mayersgm/WaterQualitySystemControl-WQSC-/CAD/WQCS_Encl_lid_v2.step

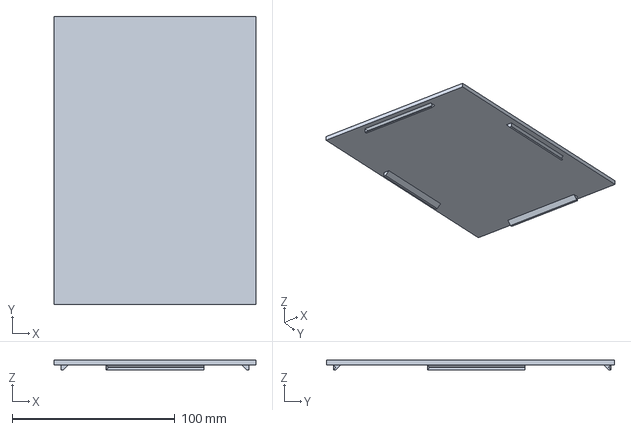
[picture p1: CAD file, 2026-10-28]
CAD/WQCS_Encl_lid_v2.step
124.0 x 177.0 x 6.00 mm
