mayersgm/WaterQualitySystemControl-WQSC-/CAD/WQCS_Enclosure_v2.step

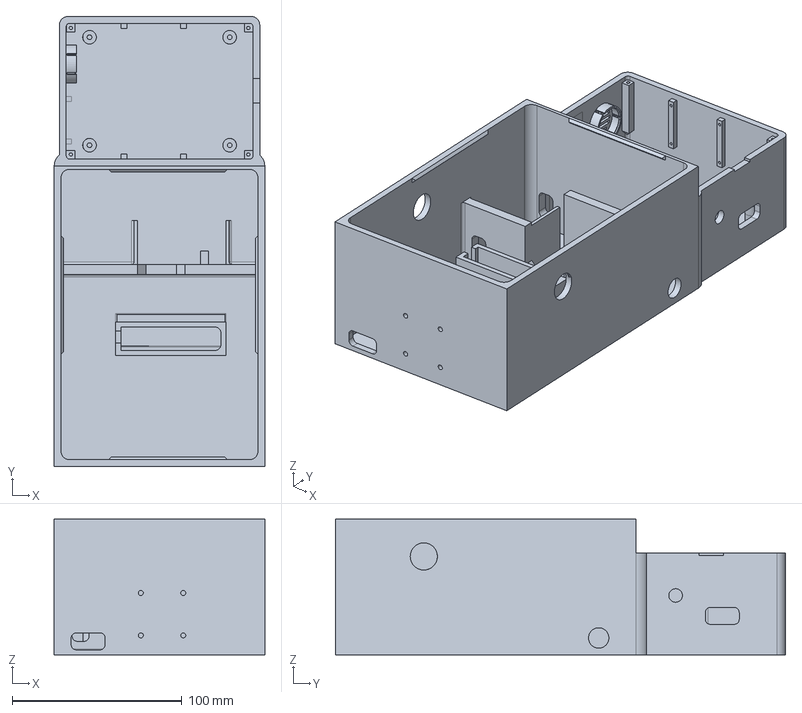
[picture p2: CAD file, 2026-10-28]
CAD/WQCS_Enclosure_v2.step
124.0 x 265.0 x 80.0 mm
