mayersgm/WaterQualitySystemControl-WQSC-/CAD/WQCS_fit_test.step

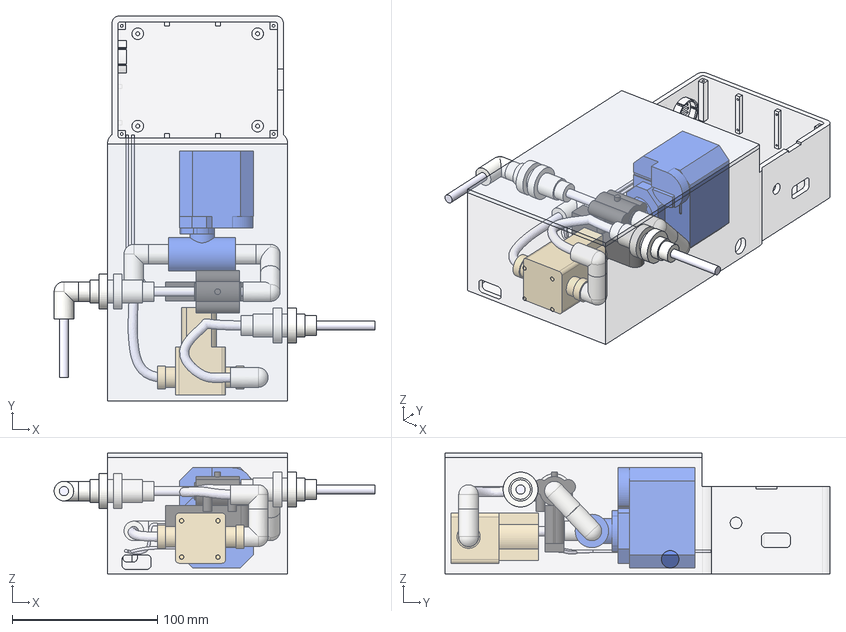
[picture p3: CAD file, 2026-10-28]
CAD/WQCS_fit_test.step
220.8 x 265.0 x 83.0 mm
enclosure_v2
lid_v2
pressure_switch
motorized_valve
solenoid_valve
bulkhead_IN
elbow_IN_outside
elbow_E1
elbow_E2
adapter_valve_R
adapter_valve_L
elbow_E3
elbow_E5
elbow_E6
bulkhead_OUT
switch_pin_1
switch_pin_2
tube_IN_supply
tube_IN_to_switch
tube_through_switch
tube_valve_to_solenoid
tube_solenoid_to_OUT
tube_OUT_boiler
wire_1
wire_1_run
wire_2
wire_2_run
