mayersgm/WaterQualitySystemControl-WQSC-/CAD/Speaker_Test_Coupon.step

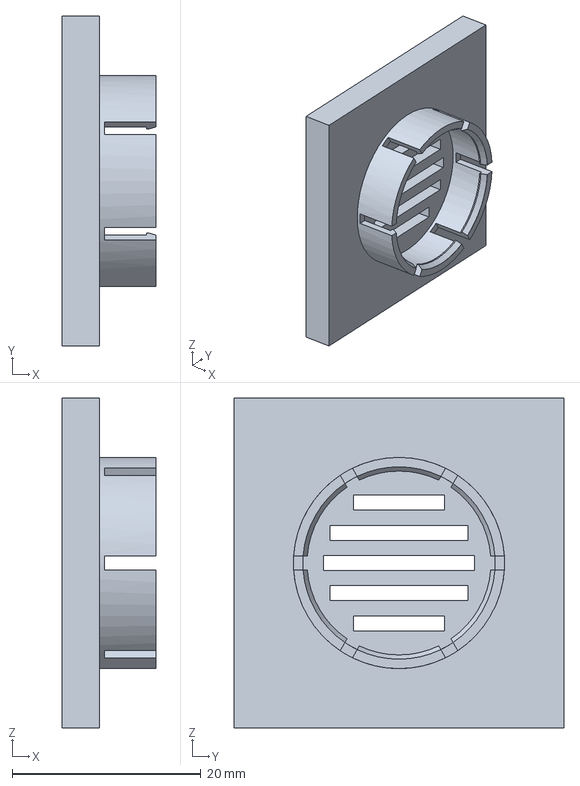
[picture p4: CAD file, 2026-10-28]
CAD/Speaker_Test_Coupon.step
10.0 x 35.0 x 35.0 mm
