mayersgm/WaterQualitySystemControl-WQSC-/CAD/Elec Water Valve.step

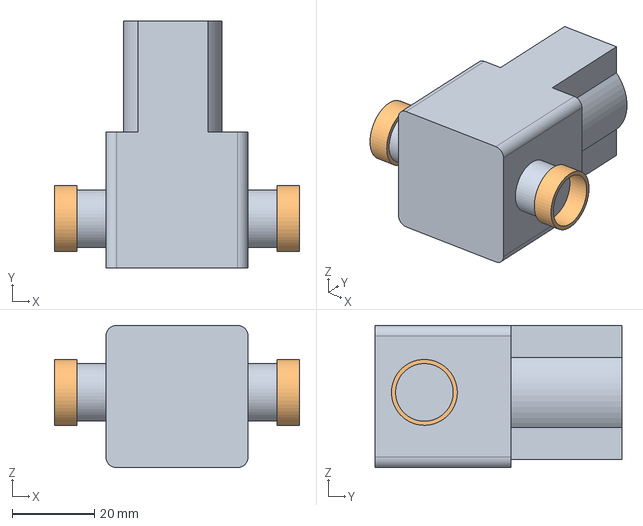
[picture p5: CAD file, 2026-10-25]
CAD/Elec Water Valve.step
59.5 x 60.0 x 34.5 mm
