mayersgm/WaterQualitySystemControl-WQSC-/CAD/Pressure_switch.step

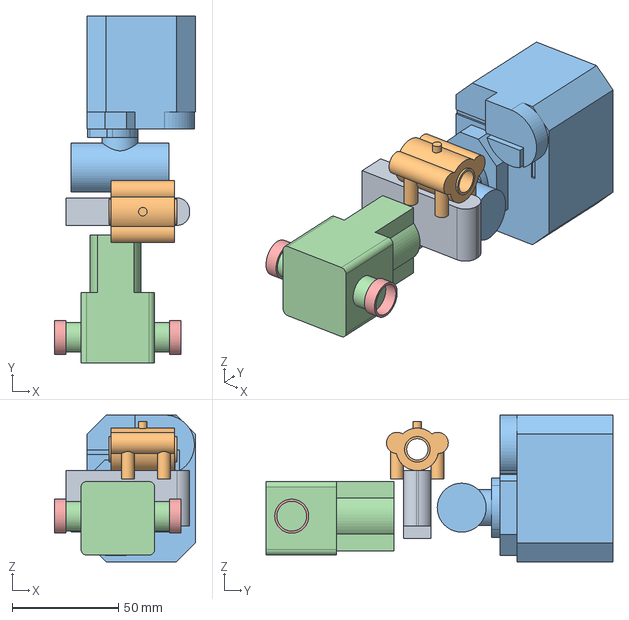
[picture p6: CAD file, 2026-10-25]
CAD/Pressure_switch.step
66.3 x 162.9 x 69.0 mm
VALVE_ENCLOSURE
SV2
