mayersgm/WaterQualitySystemControl-WQSC-/CAD/Display_Cover_v2.step

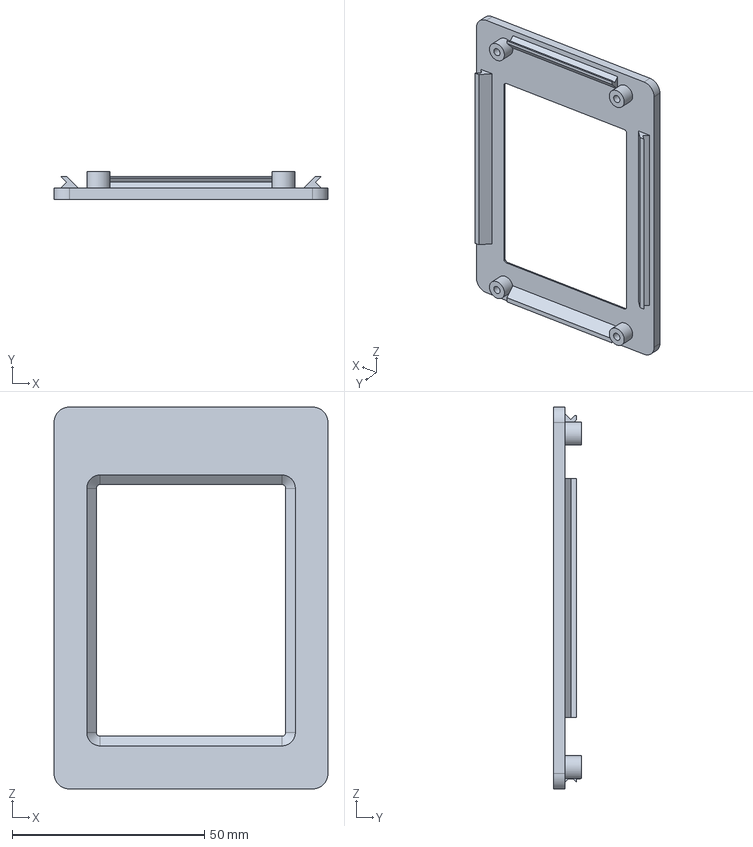
[picture p7: CAD file, 2026-10-25]
CAD/Display_Cover_v2.step
71.2 x 7.30 x 99.3 mm
