mayersgm/WaterQualitySystemControl-WQSC-/CAD/WQCS_Display_Case_v2.step

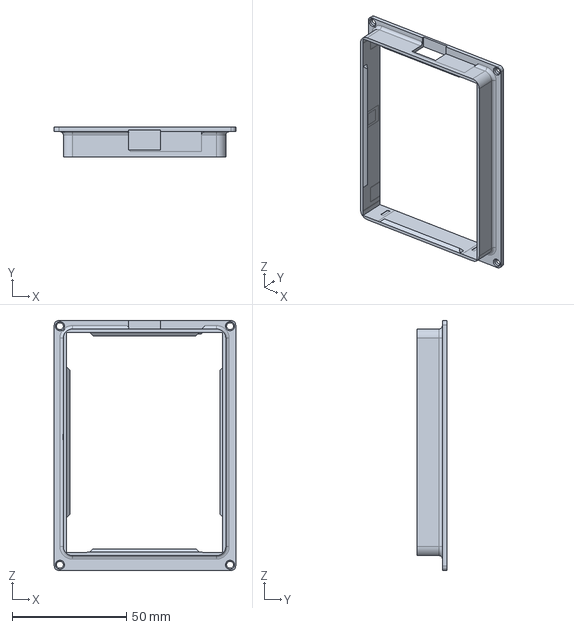
[picture p8: CAD file, 2026-10-25]
CAD/WQCS_Display_Case_v2.step
79.5 x 13.0 x 109.5 mm
