mayersgm/WaterQualitySystemControl-WQSC-/CAD/ESP32-2432S032C.step

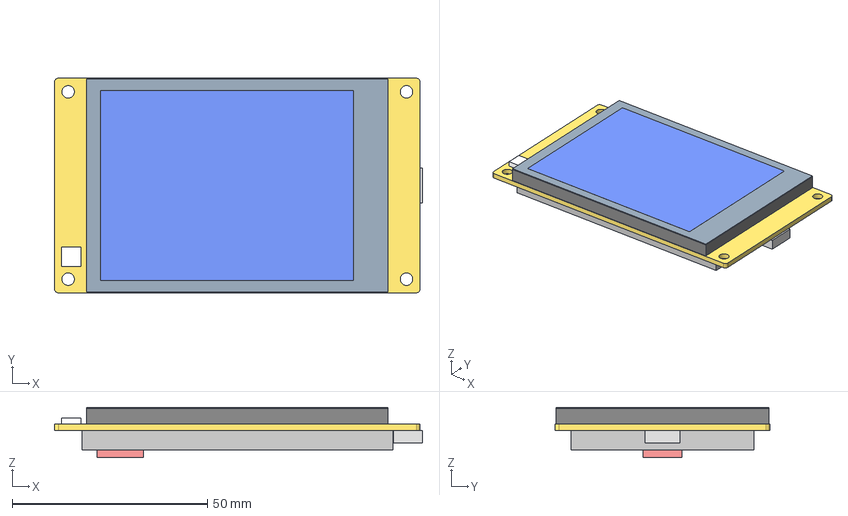
[picture p9: CAD file, 2026-10-24]
CAD/ESP32-2432S032C.step
94.3 x 55.0 x 12.9 mm
pcb
display_module
glass
active_area
back_parts_envelope
speaker_plug_zone
usb_c
rgb_led
