mayersgm/WaterQualitySystemControl-WQSC-/CAD/wqcs_pcb.step

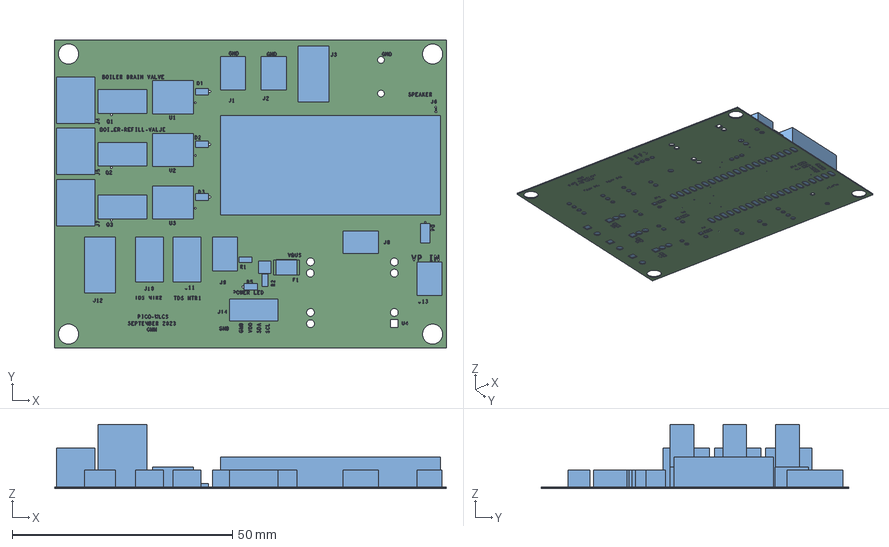
[picture p10: CAD file, 2026-10-22]
CAD/wqcs_pcb.step
88.9 x 69.8 x 14.6 mm
