mayersgm/WaterQualitySystemControl-WQSC-/CAD/WQCS_Display_Case_v1.step

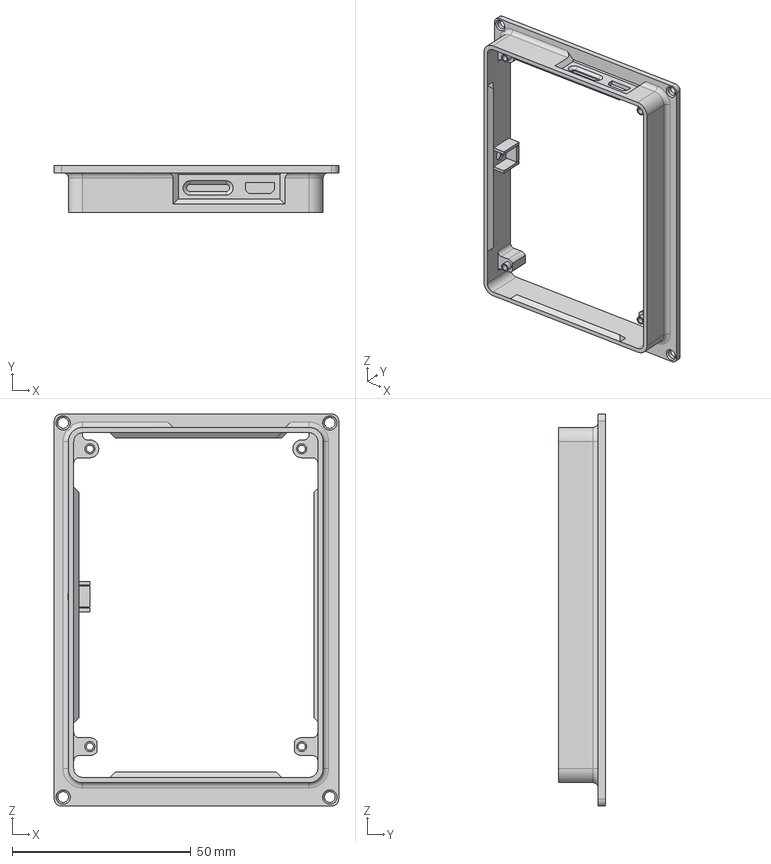
[picture p11: CAD file, 2026-10-23, an earlier design]
CAD/WQCS_Display_Case_v1.step
79.5 x 13.0 x 109.5 mm
