mayersgm/WaterQualitySystemControl-WQSC-/CAD/Display_Cover.step

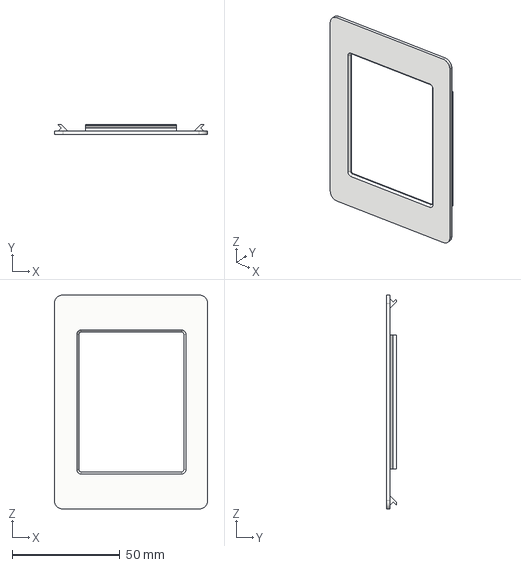
[picture p12: CAD file, 2026-10-23, an earlier design]
CAD/Display_Cover.step
71.2 x 4.50 x 99.3 mm
Parts
Case Plate
