mayersgm/WaterQualitySystemControl-WQSC-/CAD/WQCS_Encl_lid_v1.step

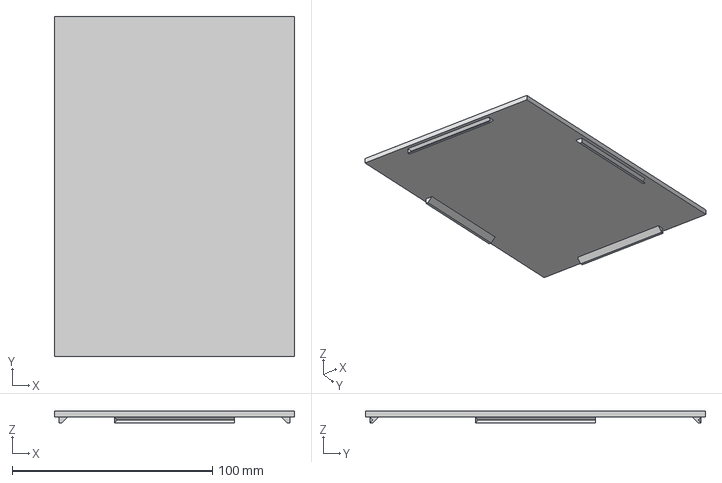
[picture p13: CAD file, 2026-10-20, an earlier design]
CAD/WQCS_Encl_lid_v1.step
120.0 x 170.0 x 6.00 mm
