mayersgm/WaterQualitySystemControl-WQSC-/CAD/WQCS_Enclosure_v1.step

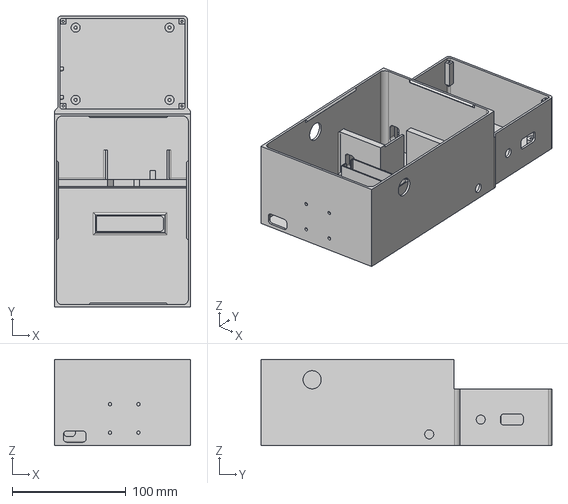
[picture p14: CAD file, 2026-10-20, an earlier design]
CAD/WQCS_Enclosure_v1.step
120.0 x 256.0 x 76.0 mm
