mayersgm/WaterQualitySystemControl-WQSC-/(list of files, cad)

Other CAD files:
CAD/MotorizeValve.step
CAD/Display_Cover_v2.stl
CAD/Speaker_Test_Coupon.stl
CAD/WQCS_Display_Case_v2.stl
CAD/WQCS_Encl_lid_v2.stl
CAD/WQCS_Enclosure_v2.stl
