mayersgm/WaterQualitySystemControl-WQSC-/LoadCells/Wiring1_ 2026-05-20 at 11.27.05 PM.png

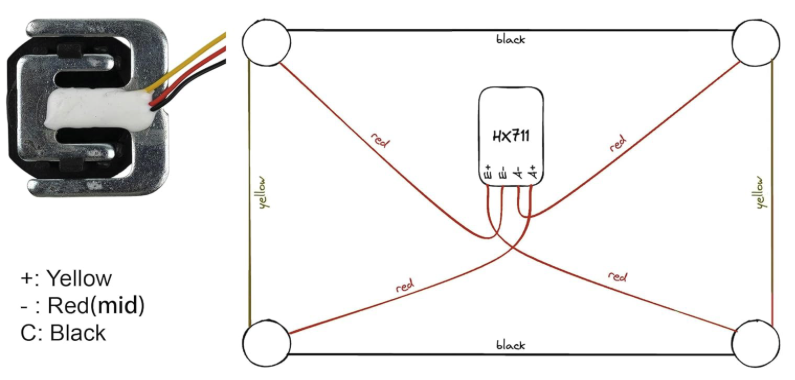
LoadCells/Wiring1_ 2026-05-20 at 11.27.05 PM.png
