mayersgm/WaterQualitySystemControl-WQSC-/LoadCells/Wiring2_2026-05-22 at 11.45.17 AM.png

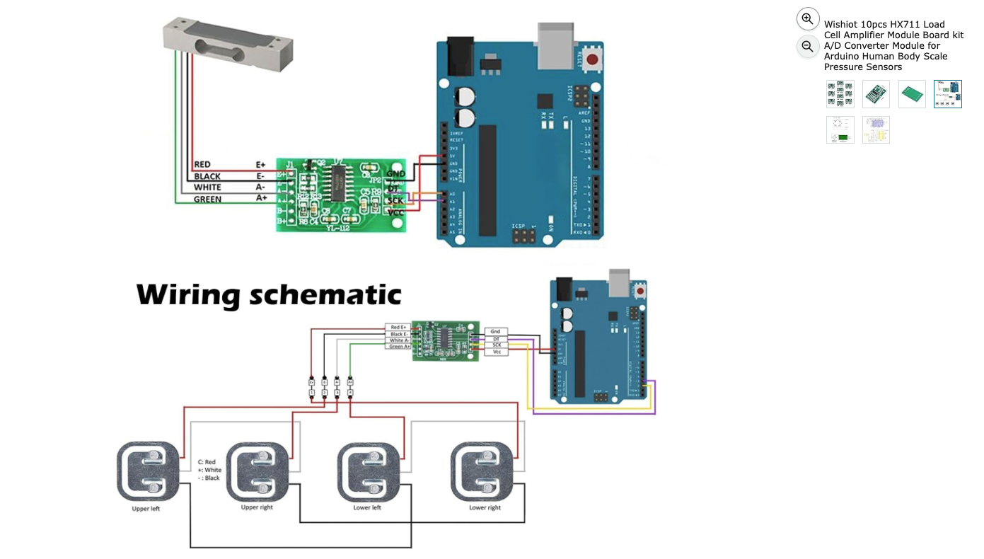
LoadCells/Wiring2_2026-05-22 at 11.45.17 AM.png
