mayersgm/WaterQualitySystemControl-WQSC-/ESP-S32CI/dashboard.py

"""Main operator screen: state, vessel levels, live indicators, commands."""
import lvgl as lv
import widgets as w
from icons import Flame, Drops, Valve, FlowArrow

BAR_Y, BAR_H = 18, 70
VESSEL_Y, VESSEL_H = 32, 116
TILE_Y, TILE_H = 151, 46

TDS_FAULT_PPM = 50                 # mirrors Pico/main.py TDS_FAULT_PPM
TDS_WARN_PPM = TDS_FAULT_PPM * 4 // 5

FAULT_NAMES = {"tds1": "TDS-1", "overflow": "BOILER OVFL",
               "refill_timeout": "REFILL T/O", "valve_stuck": "VALVE STUCK",
               "collector_overflow": "COLL OVFL", "reservoir_overflow": "RES OVFL",
               "transfer_leak": "XFER LEAK", "controller": "CTRL STALL",
               "sensor": "SENSOR"}

STATE_STYLE = {
    "RUN": (w.GREEN, "RUN - distilling"),
    "IDLE": (w.BLUE, "IDLE - filling boiler"),
    "STANDBY": (w.AMBER, "STANDBY - no room"),
    "STOPPED": (w.GREY, "STOPPED"),
    "EMPTY": (w.TEAL, "EMPTY - drain mode"),
    "FAULT": (w.RED, "FAULT"),
}

# setpoints drawn as markers on each vessel (FULL is the top of the bar)
MARKERS = {
    "boiler": ("boiler_topoff", "boiler_full"),
    "collector": ("collector_empty", "collector_full"),
    "reservoir": ("reservoir_full",),
}


class _Vessel:
    """Level bar scaled to the operator's settings: 0% = empty, 100% = the
    vessel's FULL setpoint (falls back to physical capacity until the Pico's
    limits arrive). The % label can exceed 100 and the bar turns amber at/over
    FULL, so overfill stays visible."""

    def __init__(self, parent, name, title, x):
        self.name = name
        self.full = None
        self.g = None
        self.panel = w.box(parent, x, VESSEL_Y, 104, VESSEL_H)
        w.label(self.panel, title, color=w.MUTED).set_pos(6, 3)
        self.bar = lv.bar(self.panel)
        self.bar.set_pos(8, BAR_Y)
        self.bar.set_size(40, BAR_H)
        self.bar.set_range(0, 100)
        # Indicator radius must be >= the bar's: if it's smaller, LVGL clips
        # the indicator through an ARGB8888 layer (40x70x4 = 11 KB) on every
        # redraw, which fragmented the heap until rendering hit MemoryError
        # (lv_bar.c draw_indic "radius_issue", 2026-10-03).
        self.bar.set_style_radius(4, 0)
        self.bar.set_style_radius(4, lv.PART.INDICATOR)
        self.bar.set_style_bg_color(lv.color_hex(0x0B1015), 0)
        self.bar.set_style_bg_opa(lv.OPA.COVER, 0)
        self.bar.set_style_bg_color(w.WATER, lv.PART.INDICATOR)
        self.markers = {}
        for key in MARKERS[name]:
            m = w.box(self.panel, 4, BAR_Y, 48, 2, w.AMBER, radius=0)
            m.add_flag(lv.obj.FLAG.HIDDEN)
            self.markers[key] = m
        self.grams = w.label(self.panel, "--", w.FONT_M)
        self.grams.set_pos(6, BAR_Y + BAR_H + 4)
        self.pct = w.label(self.panel, "", color=w.MUTED)
        self.pct.set_pos(56, 3)
        self.room = None
        if name == "reservoir":
            # "no room" line: above it, a full collector no longer fits
            self.room = w.box(self.panel, 4, BAR_Y, 48, 2, w.TEAL, radius=0)
            self.room.add_flag(lv.obj.FLAG.HIDDEN)

    def _pct(self, g):
        scale = self.full or w.CAPACITY[self.name]
        return int(100 * g / scale) if scale > 0 else 0

    def _y(self, p):
        p = max(0, min(100, p))
        return BAR_Y + BAR_H - 1 - (BAR_H * p) // 100

    def set_weight(self, g):
        self.g = g
        if g is None:
            return
        p = self._pct(g)
        bar_p = max(0, min(100, p))
        if w.changed(self.bar, "value", bar_p):
            self.bar.set_value(bar_p, True)  # LVGL 9: lv_anim_enable_t is a bool, no lv.ANIM enum
        over = self.full is not None and g >= self.full
        if w.changed(self.bar, "over", over):
            self.bar.set_style_bg_color(w.AMBER if over else w.WATER, lv.PART.INDICATOR)
        # 10 g resolution: sub-10 g scale jitter would otherwise redraw every second
        w.set_text(self.grams, w.fmt_g(round(g, -1)))
        w.set_text(self.pct, "%d%%" % p)

    def set_limits(self, limits):
        self.full = limits.get(self.name + "_full") or None
        for key, m in self.markers.items():
            if key in limits:
                m.set_y(self._y(self._pct(limits[key])))
                m.remove_flag(lv.obj.FLAG.HIDDEN)
        if self.g is not None:
            self.set_weight(self.g)   # rescale the bar to the new FULL

    def set_room_line(self, room_g):
        """Reservoir only: level above which a full collector won't fit."""
        if self.room is None or self.full is None:
            return
        y = self._y(self._pct(room_g))
        if w.changed(self.room, "y", y):
            self.room.set_y(y)
        w.set_hidden(self.room, False)


class _Tile:
    """Sensor readout: small title, large value, colored by status."""

    def __init__(self, parent, title, x):
        self.panel = w.box(parent, x, TILE_Y, 104, TILE_H)
        w.label(self.panel, title, color=w.MUTED).set_pos(6, 3)
        self.value = w.label(self.panel, "--", w.FONT_L, w.MUTED)
        self.value.set_pos(6, 18)

    def set(self, text, color):
        w.set_text(self.value, text)
        w.set_text_color(self.value, color)


def _tds_color(ppm, faulted):
    if faulted or ppm >= TDS_FAULT_PPM:
        return w.RED
    return w.AMBER if ppm >= TDS_WARN_PPM else w.GREEN


class Dashboard:
    def __init__(self, on_command, on_cal, on_levels, on_ack):
        self.on_command = on_command
        self.scr = w.screen()
        self.cmd = None
        self.frame = 0

        self.banner = w.box(self.scr, 0, 0, 320, 30, w.GREY, radius=0)
        self.state_lbl = w.label(self.banner, "WAITING FOR PICO...", w.FONT_M)
        self.state_lbl.align(lv.ALIGN.LEFT_MID, 8, 0)
        w.button(self.banner, "CAL", on_cal, 222, 2, 44, 26, w.PANEL, w.FONT_S)
        w.button(self.banner, lv.SYMBOL.SETTINGS + " LVL", on_levels, 270, 2, 48, 26,
                 w.PANEL, w.FONT_S)
        # shown only while a fault is latched; the fault names go in state_lbl
        self.btn_ack = w.button(self.banner, "ACK", on_ack,
                                166, 2, 52, 26, lv.color_hex(0x7F0000), w.FONT_M, tone=w.TONE_ACK)
        self.btn_ack.add_flag(lv.obj.FLAG.HIDDEN)

        self.vessels = {
            "boiler": _Vessel(self.scr, "boiler", "BOILER", 2),
            "collector": _Vessel(self.scr, "collector", "COLLECTOR", 108),
            "reservoir": _Vessel(self.scr, "reservoir", "RESERVOIR", 214),
        }
        bp = self.vessels["boiler"].panel
        self.main_valve = Valve(bp, 54, 18, "MAIN")
        self.drops = Drops(bp, 58, 32, height=20)
        self.flame = Flame(bp, 62, 56)
        self.psw = Valve(bp, 58, 94, "PSW")
        cp = self.vessels["collector"].panel
        w.label(cp, "XFER", color=w.MUTED).set_pos(58, 36)
        self.flow = FlowArrow(cp, 56, 52)
        self.animated = (self.flame, self.drops, self.flow)

        self.t_temp = _Tile(self.scr, "BOILER TEMP", 2)
        self.t_tds1 = _Tile(self.scr, "TDS-1 DISTILL", 108)
        self.t_tds2 = _Tile(self.scr, "TDS-2 OUTLET", 214)

        cmd = w.TONE_CMD
        self.btn_start = w.button(self.scr, "START", self._start_stop, 2, 201, 76, 37, w.GREEN,
                                  tone=cmd)
        self.btn_ster = w.button(self.scr, "STERILIZE", self._sterilize, 82, 201, 76, 37,
                                 w.PURPLE, w.FONT_S, tone=cmd)
        self.btn_empty = w.button(self.scr, "EMPTY", self._empty, 162, 201, 76, 37, w.TEAL,
                                  tone=cmd)
        w.button(self.scr, "RESET", lambda: on_command("RESET"), 242, 201, 76, 37, w.GREY,
                 tone=cmd)

        lv.timer_create(self._animate, 150, None)

    # -- commands: labels follow the Pico's reported cmd, not local state --
    def _start_stop(self):
        self.on_command("STOP" if self.cmd == "START" else "START")

    def _sterilize(self):
        self.on_command("STOP" if self.cmd == "STERILIZE" else "STERILIZE")

    def _empty(self):
        self.on_command("STOP" if self.cmd == "EMPTY" else "EMPTY")

    def _animate(self, timer):
        self.frame += 1
        for icon in self.animated:
            icon.step(self.frame)

    # -- data in --
    def update(self, s):
        self.cmd = s.get("cmd")
        state = s.get("state", "")
        color, text = STATE_STYLE.get(state, (w.GREY, state))
        if state == "RUN" and self.cmd == "STERILIZE":
            text = "RUN - sterilizing"
        elif state == "STANDBY":
            # collector FULL: draining into the reservoir, or waiting for room
            text = ("STANDBY - transferring" if s.get("valves", {}).get("transfer")
                    else "STANDBY - no room")
        faults = [k for k, on in s.get("fault", {}).items() if on]
        if faults:
            color = w.RED
            text = "FAULT " + "+".join(FAULT_NAMES.get(k, k) for k in faults)
        w.set_hidden(self.btn_ack, not faults)
        self._set_banner(color, text, small=bool(faults))

        for name, v in self.vessels.items():
            v.set_weight(s.get(name + "_g"))
        res, coll_g = self.vessels["reservoir"], s.get("collector_g")
        if res.full is not None and coll_g is not None:
            res.set_room_line(res.full - max(0, coll_g))

        valves = s.get("valves", {})
        self.main_valve.set_active(bool(valves.get("main")))
        self.drops.set_active(bool(valves.get("refill")))
        self.flow.set_active(bool(valves.get("transfer")))
        self.flame.set_active(bool(s.get("heater")))
        self.psw.set_active(bool(s.get("pressure_sw")))

        temp = s.get("temp_f")
        if temp is None:
            self.t_temp.set("-- F", w.MUTED)  # sensor missing / out of range
        else:
            self.t_temp.set("%.0f F" % temp, w.AMBER if self.flame.active else w.TEXT)
        tds1 = s.get("tds1_ppm") or 0
        tds2 = s.get("tds2_ppm") or 0
        self.t_tds1.set("%d ppm" % tds1, _tds_color(tds1, s.get("fault", {}).get("tds1")))
        self.t_tds2.set("%d ppm" % tds2, _tds_color(tds2, s.get("alert", {}).get("tds2")))

        w.set_button_text(self.btn_start, "STOP" if self.cmd == "START" else "START")
        w.set_bg(self.btn_start, w.RED if self.cmd == "START" else w.GREEN)
        w.set_button_text(self.btn_ster, "CANCEL" if self.cmd == "STERILIZE" else "STERILIZE")
        w.set_button_text(self.btn_empty, "CANCEL" if self.cmd == "EMPTY" else "EMPTY")

    def _set_banner(self, color, text, small=False):
        w.set_bg(self.banner, color)
        w.set_text_color(self.state_lbl, w.DARK_TEXT if color is w.AMBER else w.TEXT)
        if w.changed(self.state_lbl, "small", small):
            self.state_lbl.set_style_text_font(w.FONT_S if small else w.FONT_M, 0)
        if w.changed(self.state_lbl, "text", text):
            self.state_lbl.set_text(text)
            self.state_lbl.align(lv.ALIGN.LEFT_MID, 8, 0)

    def update_limits(self, limits):
        for v in self.vessels.values():
            v.set_limits(limits)

    def show_link_lost(self, errors):
        self._set_banner(w.PURPLE, "NO LINK TO PICO" + (" (err %d)" % errors if errors else ""))
