mayersgm/WaterQualitySystemControl-WQSC-/tests/test_control.py

"""Runs the Pico's real _control_step against scripted weights (bench limits:
collector_full 500, collector_empty 100, reservoir_full 1000; overflow ceilings
boiler 900 / collector 900 / reservoir 1200)."""
import os
import tempfile
import unittest

import fake_pico


class ControlTest(unittest.TestCase):
    def setUp(self):
        self._cwd = os.getcwd()
        self.dir = tempfile.TemporaryDirectory()
        self.main, self.w = fake_pico.make_controller(self.dir.name)
        # the bench pressure-switch stand-in follows the refill command; keep it
        # "healthy" so the unrelated stuck-solenoid check never trips here
        self.w.cmd = "START"
        self.set(boiler=600, collector=0, reservoir=0)

    def tearDown(self):
        os.chdir(self._cwd)
        self.dir.cleanup()

    def set(self, **grams):
        for name, g in grams.items():
            self.w.scales[name].v = g

    def step(self, n=4):
        m = self.main
        for _ in range(n):
            # healthy pressure switch: blocked when refill closed, flowing when open
            m.PRESSURE_SW.value(0 if self.w.refill_open == m.PRESSURE_SW_ACTIVE_HIGH else 1)
            self.w._control_step()
        return self.w.last_status

    def faults(self):
        return {k for k, v in self.w.last_status["fault"].items() if v}

    # -- the capacity rule, and the old overflow gap it closes --
    def test_full_collector_that_does_not_fit_pauses_production(self):
        # 520 + 600 = 1120 > reservoir_full 1000. The old logic (transfer only
        # below reservoir_low, pause only when BOTH full) did neither here and
        # kept distilling into a full collector.
        self.set(collector=520, reservoir=600)
        s = self.step()
        self.assertEqual(s["state"], "STANDBY")
        self.assertEqual(s["heater"], 0)
        self.assertEqual(s["valves"]["main"], 0)
        self.assertEqual(s["valves"]["transfer"], 0)

    def test_transfer_starts_once_the_whole_collector_fits(self):
        self.set(collector=520, reservoir=600)
        self.step()
        self.set(reservoir=450)                      # pump drew it down: 970 <= 1000
        s = self.step()
        self.assertEqual(s["valves"]["transfer"], 1)
        self.assertEqual(s["state"], "STANDBY")      # still paused: collector >= FULL

    def test_full_collector_pauses_even_when_it_fits(self):
        # user rule 2026-09-29: collector at/above FULL -> STANDBY whatever the
        # reservoir holds; the transfer drains it meanwhile, production resumes
        # once the collector is back below FULL.
        self.set(collector=520, reservoir=0)
        s = self.step()
        self.assertEqual((s["state"], s["heater"], s["valves"]["main"]), ("STANDBY", 0, 0))
        self.assertEqual(s["valves"]["transfer"], 1)
        self.set(collector=400, reservoir=120)       # drained below FULL
        s = self.step()
        self.assertEqual((s["state"], s["heater"]), ("RUN", 1))
        self.assertEqual(s["valves"]["transfer"], 1)  # keeps going to EMPTY

    def test_production_pauses_if_total_outgrows_capacity_mid_transfer(self):
        # bench case 2026-09-29: transfer running, then the total grew to
        # 1798 g > 1000 g; production kept going because STANDBY was skipped
        # during transfers. Now it pauses; the transfer runs on to FULL.
        self.set(collector=520, reservoir=100)
        self.assertEqual(self.step()["valves"]["transfer"], 1)
        self.set(collector=824, reservoir=974)
        s = self.step()
        self.assertEqual((s["state"], s["heater"], s["valves"]["main"]), ("STANDBY", 0, 0))
        self.assertEqual(s["valves"]["transfer"], 1)
        self.set(reservoir=1000)                     # reservoir FULL ends the transfer
        self.assertEqual(self.step()["valves"]["transfer"], 0)

    def test_nearly_overflowing_collector_always_fits_empty_reservoir(self):
        # bench case 2026-09-29: collector at 860 g never fit the old 800 g
        # capacity even into an empty reservoir -> STANDBY forever. Validation
        # now requires reservoir capacity >= the collector overflow ceiling.
        self.set(collector=860, reservoir=20)
        self.assertEqual(self.step()["valves"]["transfer"], 1)

    def test_transfer_runs_until_collector_empty(self):
        self.set(collector=520, reservoir=100)
        self.assertEqual(self.step()["valves"]["transfer"], 1)
        self.set(collector=300, reservoir=320)       # gravity, slow: still open
        self.assertEqual(self.step()["valves"]["transfer"], 1)
        self.set(collector=80, reservoir=540)
        self.assertEqual(self.step()["valves"]["transfer"], 0)
        self.assertEqual(self.faults(), set())       # a normal transfer isn't a leak

    # -- overflow faults (valve stuck closed / open) --
    def test_collector_overflow_stops_distillation(self):
        self.set(collector=950, reservoir=5000)      # can't fit, keeps filling
        s = self.step()
        self.assertIn("collector_overflow", self.faults())
        self.assertEqual((s["heater"], s["valves"]["main"], s["state"]), (0, 0, "FAULT"))

    def test_reservoir_overflow_stops_distillation_and_blocks_transfer(self):
        self.set(collector=520, reservoir=1250)
        s = self.step()
        self.assertIn("reservoir_overflow", self.faults())
        self.assertEqual((s["heater"], s["valves"]["transfer"]), (0, 0))

    # -- leak detection (no timing) --
    def test_closed_valve_leak_detected(self):
        self.set(collector=450, reservoir=100)       # not full: valve stays closed
        self.step()
        self.set(collector=100, reservoir=440)       # water moved anyway
        s = self.step()
        self.assertIn("transfer_leak", self.faults())
        self.assertEqual((s["heater"], s["valves"]["transfer"]), (0, 0))

    def test_lifting_collector_jar_is_not_a_leak(self):
        self.set(collector=450, reservoir=100)
        self.step()
        self.set(collector=0)                        # jar lifted, reservoir unchanged
        self.step()
        self.assertNotIn("transfer_leak", self.faults())

    def test_ack_rearms_leak_check_from_current_weights(self):
        self.set(collector=450, reservoir=100)
        self.step()
        self.set(collector=100, reservoir=440)
        self.step()
        self.w._handle_command("ACK")
        self.step()
        self.assertNotIn("transfer_leak", self.faults())

    # -- contaminated distillate must not reach the reservoir --
    def test_tds1_fault_blocks_transfer(self):
        self.w.tds1.v = 80
        self.set(collector=520, reservoir=100)
        s = self.step()
        self.assertIn("tds1", self.faults())
        self.assertEqual(s["valves"]["transfer"], 0)

    # -- a dead or stuck control loop must fail safe (2026-10-01 incident) --
    def heat(self):
        """Running with the heater on, as in the incident."""
        self.set(boiler=600, collector=0, reservoir=0)
        s = self.step()
        self.assertEqual(s["heater"], 1)
        return s

    def outputs(self):
        m = self.main
        return [p.value() for p in (m.MAIN_VALVE, m.REFILL_VALVE, m.TRANSFER_VALVE, m.BOILER_RELAY)]

    def test_exception_in_control_step_fails_safe(self):
        self.heat()
        def boom():
            raise MemoryError("simulated")
        self.w._control_step = boom
        self.w.loop_once()                      # must not raise
        self.assertEqual(self.outputs(), [0, 0, 0, 0])
        self.assertTrue(self.w.faults["controller"])
        self.assertEqual(self.w.last_status["heater"], 0)
        self.assertEqual(self.w.last_status["state"], "FAULT")
        self.assertTrue(self.w.last_status["fault"]["controller"])

    def test_exception_in_command_handling_fails_safe(self):
        self.heat()
        self.w._handle_command = lambda line: 1 / 0
        self.w.queue_command("START")
        self.w.loop_once()
        self.assertEqual(self.outputs(), [0, 0, 0, 0])
        self.assertTrue(self.w.faults["controller"])

    def test_stalled_loop_forces_outputs_off_and_silences_status(self):
        self.heat()
        clock = self.main.time
        self.w.loop_once()
        self.assertTrue(self.w.supervise(clock.ticks_ms()))
        clock.now += self.main.STALL_MS + 1      # core 0 stuck in a sensor read
        self.assertFalse(self.w.supervise(clock.ticks_ms()))
        self.assertEqual(self.outputs(), [0, 0, 0, 0])

    def test_recovered_loop_latches_fault_until_ack(self):
        self.heat()
        clock = self.main.time
        clock.now += self.main.STALL_MS + 1
        self.w.supervise(clock.ticks_ms())
        self.w.loop_once()                       # core 0 comes back
        self.assertTrue(self.w.supervise(clock.ticks_ms()))
        self.assertIn("controller", self.faults())
        self.assertEqual(self.w.last_status["heater"], 0)   # any fault stops distillation
        self.w.queue_command("ACK")
        self.w.loop_once()
        self.w.loop_once()
        self.assertNotIn("controller", self.faults())
        self.assertEqual(self.w.last_status["heater"], 1)

    def break_scale(self, name="boiler"):
        good = self.w.scales[name]

        class Dead:
            def read_grams(self):
                raise OSError("HX711 not ready")
        self.w.scales[name] = Dead()
        return good

    def test_sensor_glitch_publishes_safe_status_without_latching(self):
        self.heat()
        good = self.break_scale()
        s = self.step(1)
        self.assertEqual(self.outputs(), [0, 0, 0, 0])
        self.assertEqual((s["heater"], s["state"]), (0, "FAULT"))   # not the stale "heater 1"
        self.assertIn("HX711", s["error"])
        self.assertEqual(self.faults(), set())
        self.w.scales["boiler"] = good                            # glitch over
        s = self.step()
        self.assertEqual((s["heater"], s["state"]), (1, "RUN"))
        self.assertNotIn("error", s)

    def test_persistent_sensor_failure_latches_fault(self):
        self.heat()
        good = self.break_scale("reservoir")
        self.step(self.main.SENSOR_FAIL_PASSES - 1)
        self.assertEqual(self.faults(), set())
        self.step(1)
        self.assertEqual(self.faults(), {"sensor"})
        self.w.scales["reservoir"] = good
        self.assertEqual(self.step()["heater"], 0)                # latched until ACK

    def test_status_reports_every_fault_key(self):
        self.assertEqual(set(self.step()["fault"]), set(self.main.FAULT_KEYS))


if __name__ == "__main__":
    unittest.main()
