mayersgm/WaterQualitySystemControl-WQSC-/(commit log)

2026-07-04 Initial commit: WQCS PyPortal/Pico control system and analysis
    Adds the existing CircuitPython (PyPortal) and MicroPython (Pico) sources
    for the Water Quality Control System along with a system analysis doc.
2026-07-04 Add CLAUDE.md project context for session continuity
    Summarizes system architecture, current git/SSH setup, and the next
    planned step (hardware upgrade planning) so a fresh session picks up
    context automatically.
2026-09-23 Phase 0-2 hardware upgrade: load-cell scales, Pico state machine, ESP32 bridge
    Fix HX711 bit-bang read corruption caused by cross-core interrupt latency
    (disable_irq/enable_irq around the pulse loop, confirmed root cause and
    fix on real hardware), recalibrate all three scales, and commit the
    accumulated Phase 0-2 work: Pico/ weight-based state machine (scale,
    sensor, valve/safety logic), ESP-S32CI/ UART bridge firmware, LoadCells/
    prototype, and design docs. Also carries small legacy main.py/.vscode
    tweaks pending from earlier sessions.
    [bench_bridge.ino, ble_uart.py, hx711.py, main.py, pico_link.py, scale.py, sensors.py]
2026-09-29 Fix relay output polarity and refill pin; simulate pressure switch on bench
    Real-hardware bench testing (Phase 2) surfaced two firmware/wiring bugs on
    the spare PCB: the main/refill/transfer valve relays are opto-isolated
    817C modules that energize on IN=LOW, not IN=HIGH as originally coded, and
    the refill solenoid is actually wired to the legacy GP18 pin, not GP10.
    Both are fixed (ActiveLowOutput wrapper, corrected pin). Since there's no
    real pressure switch on the bench yet, add a clearly-flagged simulation
    relay (GP10, active-high) driven in lockstep with the real refill solenoid,
    standing in for genuine back-pressure feedback until Phase 6. Also lower
    the fill/transfer weight thresholds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
    [main.py, scale_monitor.py]
2026-09-29 Fix truncated Pico status telemetry; add operator-adjustable water limits
    rp2 uart.write() queues only what fits in the TX buffer (~288B) and silently
    drops the rest, so every ~400B status line reached the ESP32 cut off before
    its newline. Give the Pico UART txbuf=1024 plus a write-all loop, and drop
    the derived *_pct fields to shorten the line: 299/300 lines, 0 errors in a
    5-minute soak (previously zero complete lines).
    Water-level setpoints (boiler topoff/full, collector empty/full, reservoir
    low/full) are now adjustable at runtime via GET:LIMITS / SET / RESET_LIMITS,
    validated against fixed safety limits (overflow ceiling, dry-tank floor,
    capacities) and persisted to limits.json on the P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
    [limits.py, main.py, pico_link.py, scale_monitor.py, test_limits.py]
2026-09-29 Add LVGL touchscreen HMI for the ESP32-2432S032C (Phase 3, Milestone 1)
    Replaces the bench stdin console with a touchscreen operator UI on custom
    lvgl_micropython firmware (MicroPython 1.27, LVGL 9.4; build notes in
    ESP-S32CI/BUILD.md). Dashboard shows state, vessel levels with limit
    markers, animated heater/refill/transfer indicators, readouts, fault banner
    with ACK, and START/STOP/STERILIZE/EMPTY/RESET. Calibration and water-level
    screens send TARE/CAL and atomic SET commands. The ESP32 stays a pure HMI;
    all control logic remains on the Pico.
    Bring-up fixes found on hardware: the GT911 touch panel is mounted 180 deg
    from the display (driver created before rotation with startup_rotation=_1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
    [calibration.py, console.py, dashboard.py, esp_deploy.py, hw.py, hwtest.py, icons.py, main.py]
2026-09-30 HMI: sensor tiles, fix render-loop freeze, fault alarm, TDS zero-cal
    - Temperature, TDS-1 and TDS-2 get dedicated status-colored tiles; faults
    move into the top banner (with ACK) so the tiles are never hidden.
    - Fix the "frozen screen" bug: the stock TaskHandler deinit()s itself on any
    exception in an LVGL callback, stopping rendering and touch while the rest
    of the HMI keeps running. A custom exception hook now logs to crash.log and
    keeps rendering, hard-resetting only on repeated errors. Heap is logged
    every minute (post-GC headroom measured stable, no leak).
    - Audible alerts on the board's speaker amp (GPIO26): repeating beep on a new
    fault until ACK, chime on TDS-2 alert / ST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
    [alarm.py, calibration.py, dashboard.py, esp_deploy.py, hw.py, main.py, pico_link.py, sensors.py]
2026-09-30 Capacity-based transfer, collector/reservoir overflow and leak faults; fix HMI hang
    Pico control logic:
    - A transfer starts only when the reservoir can take the whole collector
    (reservoir + collector <= reservoir capacity). STANDBY pauses production
    when the collector is FULL and it doesn't fit. This closes a gap where a full
    collector with the reservoir between the old LOW and FULL setpoints neither
    transferred nor paused, and could overflow. Reservoir LOW is removed.
    - New weight-based faults (no timing; gravity flow can be arbitrarily slow):
    collector overflow (valve stuck closed), reservoir overflow (stuck open),
    and transfer leak (collector drops from its peak AND reservoir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
    [calibration.py, dashboard.py, fake_pico.py, limits.py, main.py, scale_monitor.py, settings.py, test_control.py]
2026-09-30 STANDBY on collector FULL; level bars scaled to settings; free HMI heap
    - Pico: the collector at/above FULL now means STANDBY whatever the reservoir
    holds (user rule). If the whole collector fits, the transfer drains it
    during STANDBY and production resumes below FULL; otherwise STANDBY waits
    for reservoir room. HMI banner distinguishes "transferring" / "no room".
    - HMI level bars: 0% = empty, 100% = the vessel's FULL setting (was physical
    capacity, so bench levels barely showed). Amber at/over FULL, % can exceed
    100, markers scale with the settings, plus a reservoir "no room" line at
    capacity - collector. Limits are refreshed from the Pico every minute.
    - Calibration and Levels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
2026-10-02 Pico: fail safe when the control loop dies or stalls
    Core 0 stopped with the heater on (likely blocked in an HX711 read) while
    core 1 kept re-sending the last status, so nothing enforced the interlocks
    and the HMI showed frozen values.
    - loop_once() catches any exception: all outputs off, latch the new
    "controller" fault (ACK to clear).
    - Core 1 supervise(): if no control pass completes within STALL_MS (5 s),
    force every output off and stop sending status, so the ESP32 shows
    NO LINK and pushes an alert instead.
    Verified on hardware by interrupting core 0: outputs off after 5 s,
    NO LINK on the touchscreen, phone alert delivered.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
    [main.py, test_control.py]
2026-10-02 Milestone 2: iPhone monitor + control over home WiFi, push alerts
    - net.py: WiFi + non-blocking HTTP server polled from the HMI loop.
    GET / (web_ui.html), GET /status, POST /cmd with a PIN, an allow-list
    (START/STOP/STERILIZE/EMPTY/RESET/ACK only) and a lockout after 5 bad PINs.
    - notify.py: alert edges (new fault, TDS-2, STANDBY with no room, link
    lost/restored) pushed to ntfy by a non-blocking main-loop sender. No
    thread: MicroPython ran LVGL's scheduled render on the thread's small
    stack, which overflowed and corrupted the IDF heap.
    - web_ui.html: mobile page that mirrors the touchscreen, Add to Home Screen.
    - Secrets live in a gitignored wifi_secrets.py (template provided).
    - F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
    [dashboard.py, esp_deploy.py, main.py, net.py, notify.py, test_net.py, wifi_secrets_example.py]
2026-10-02 Pico: publish fail-safe status on sensor errors; latch "sensor" fault
    A failed sensor read turned the outputs off but returned without updating
    last_status, so core 1 kept reporting the stale status (heater on, old
    weights), and the pass still completed, so the stall check never fired.
    Now every failed pass publishes state FAULT, heater 0, valves closed and
    the error text. SENSOR_FAIL_PASSES (5) consecutive failures latch a new
    "sensor" fault (ACK to clear) that the ESP32 pushes to the phone. The
    controller-fault path shares the same _fail_safe(). The HMI, push alerts
    and phone page know the new fault; the page shows the Pico's error text.
    Host-tested (63 tests, mutation-checked). ESP32 sid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
    [dashboard.py, main.py, notify.py, test_control.py]
2026-10-03 Phone access: WiFi power saving off; test alert + push counters
    - After idling, the HMI was unreachable for several seconds: the ESP32
    STA power saving drops new connections until traffic wakes the radio.
    It runs on mains power, so set PM_NONE.
    - "Send test alert" link on the phone page (PIN required, TEST_PUSH,
    handled on the ESP32 and never relayed to the Pico) to confirm ntfy
    delivery on demand, since alerts otherwise only fire on events.
    - /status adds uptime_s and push sent/failed/queued, shown on the page.
    [net.py, test_net.py]
2026-10-03 HMI WiFi: escalating recovery, wifi.log, /log endpoint
    After an overnight router restart the HMI stayed off WiFi with only plain
    connect() retries. Now, while down: connect() every 30 s, restart the WiFi
    driver after 2 min, and restart the ESP32 after 10 min, but only if WiFi
    had been up this boot, so a router that's off for hours can't cause a
    reboot loop. Associated-without-an-address counts as down. The listener is
    rebuilt after a reconnect. Every step is appended to wifi.log (rotated at
    4 KB, no secrets), readable at GET /log; /status adds wifi_drops.
    [net.py, test_net.py]
2026-10-03 HMI: speaker click on every button press
    A short quiet tick (2.6 kHz, 18 ms, quarter of alarm volume) on touch-down
    for every widgets.button, so it feels immediate. Skipped while any alert
    pattern is playing, so a tap never cuts off or masks an alarm; an alarm
    that starts during a click plays at full volume.
    [alarm.py, main.py, test_alarm.py, widgets.py]
2026-10-03 HMI: fix resets under rapid button presses; per-button click tones
    Pressing buttons quickly (mostly +/- on the Levels screen, which
    auto-repeats ~10x/s) froze and reset the HMI: MemoryError in render, and
    panics when the touch driver's I2C alloc found the IDF heap empty. The
    Levels screen redrew every label and colour on each step, fragmenting the
    MicroPython heap until it grew by taking the largest IDF block.
    - settings.py / calibration.py: change-only label, colour, bg and hidden
    updates through the widgets helpers, as the dashboard already does.
    - main.py: opening CAL or Levels first deletes any other secondary screen,
    so rapid taps can't hold two at once.
    - Click tones by role: TONE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
    [alarm.py, calibration.py, dashboard.py, main.py, settings.py, test_alarm.py, widgets.py]
2026-10-03 HMI: match bar indicator radius to stop 11 KB render layers
    The vessel bars had radius 4 with an indicator radius of 2, so LVGL drew
    each indicator through an ARGB8888 clip layer (40x70x4 = 11 KB) on every
    redraw. The 11203-byte allocation failed after heavy Levels-screen use and
    the HMI reset with MemoryError in render, mostly on Back to the dashboard.
    [dashboard.py]
2026-10-03 Firmware: keep a 24 KB IDF heap reserve; log MemoryError size
    With the Levels screen open, the GC heap had 28 KB free but its largest
    free block was only 2.8 KB (fragmentation), so a render allocation forced
    the heap to grow, and stock MicroPython gave it the entire largest IDF
    block. WiFi and the GT911's I2C then failed (panic) or the next render hit
    MemoryError. The patched gc_get_max_new_split() always leaves 24 KB for the
    drivers (documented in BUILD.md as a vendored change; verified on
    hardware). The render MemoryError message now includes the failed
    allocation size.
    [main.py]
2026-10-03 Add Milestone 2 hardware test checklist
    Lists what's already verified on hardware (with dates) and the remaining
    manual tests with expected results: every phone button, a real fault with
    push and phone ACK, the PIN lockout, sensor failure, WiFi recovery, the
    touchscreen under phone polling, a multi-day run, and the TDS/STANDBY tests
    that need more hardware.
2026-10-20 Enclosure v2: mechanical section +4 mm; CAD tooling
    CAD/wqcs_case_v2.py rebuilds WQCS_Enclosure_v2.step from the Fusion export
    (v1). The main body (y -190..-20) is split in a plain wall band (z 1.5..5.5),
    its top raised 4 mm and the gap filled with the same profile: 76 -> 80 mm
    tall. Walls, cross wall and corner posts lengthen. Glands, rim and lid
    snap-fit move up together, so the v1 lid fits unchanged (checked: no overlap
    when raised 4 mm). The front section is unchanged (same volume). The
    display cover for the front section is drafted in the script but off
    (BUILD_COVER) until that section is decided.
    tools/cad_inspect.py (holes, bosses, flat faces) and tools/cad_render.py
    (shaded PNG view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
2026-10-20 Enclosure v2: second TDS board mount in the display section
    Both EK2169 TDS boards must sit in the display section, away from the
    water valves in case of a leak. The existing mount on the left inner wall
    is two vertical rails (3.5 x 3 mm, dia 1.5 pilots, 25 x 35 mm pattern).
    The script copies them 34 mm along the wall: board 2 at y 25..57, ~2 mm
    from board 1 and from the corner post. The solid is valid. The boards
    don't overlap; the only contact is the existing board's harmless corner
    near a main-PCB floor standoff, mirrored. WQCS_v2_tds_fit_check.step (not
    committed) has stand-in boards for review.
2026-10-22 Enclosure v2: TDS-2 on the bottom wall; fit check with the real main PCB
    Photos of the installed unit show no room on the left wall for a second
    TDS board (MOSFETs, screw terminals, wiring), so TDS-2 moves to the
    display section's bottom wall (shared with the mechanical section). It
    lies along the wall (42 x 32 mm), on rails matching TDS-1 (3.5 x 3 mm,
    dia 1.5 pilots, 35 x 25 pattern), board x -45..-3, z -28.5..3.5: above the
    main PCB's bottom-edge parts (<= 3.8 mm) and clear of the harness slot.
    The fit check now places the real main PCB (wqcs_pcb.step, as installed)
    on its floor standoffs and prints clash volumes. TDS-2 clears the
    enclosure, the PCB and its parts, with a 6 mm allowance fo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
2026-10-22 Enclosure v2: TDS-1 to the top wall, TDS-2 on the bottom wall
    The top wire bundle goes away in the new setup, so TDS-1 moves from the
    left wall to the display section's top wall (inner y 64), mirroring TDS-2
    on the bottom wall. The original left-wall rails are removed (guarded:
    exactly 2 rail solids), freeing that side for the MOSFET/terminal wiring.
    Both rails come from one builder. The fit check against the real main PCB
    shows no clashes for either board (6 mm part allowance).
2026-10-22 Enclosure v2: harness under the main PCB; standoffs +4 mm; floor slot
    The harness (5 cables dia 4: 2x TDS, 3x scales; 8 wires 18-20 AWG: boiler
    sw, refill, main and transfer valve pairs; ~96 mm^2) now runs under the
    main PCB.
    - Floor standoffs 6 -> 10 mm: ~8 mm under the board after ~2 mm of leads,
    enough for the cables flat with the wires on top (~6.3 mm). The display
    still clears the MOSFETs by ~12 mm.
    - New floor-level slot through the wall shared with the mechanical
    section, 30 x 9 mm rounded (~253 mm^2, < 40 % fill so plugs pull
    through), centred under the board. Only wall material is removed. The
    old high slot stays as a spare.
    - TDS-1 moves to the left half of the top wall (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
2026-10-22 Enclosure v2: display/PCB section 48 -> 58 mm inside; more room for all
    User: the PCB/display section can grow to ~58 mm inside. It's lifted 10
    mm the same way as the mechanical section (split in its plain wall band
    z -15..-2). Rim 6.5 -> 16.5, cover pads 4 -> 14 with their pilots, so a
    flush cover seats the same way. The old left-wall TDS-1 rails are now
    removed before the lifts so they aren't stretched. lift_region() is
    shared by both lifts.
    Using the room:
    - Board standoffs 6 -> 12 mm: ~10 mm under the board for the harness.
    - Harness slot 30 x 11 mm (~304 mm^2, ~32 % fill).
    - Both TDS boards centred on the top/bottom walls at z -18.5..13.5,
    >= 7 mm above every main-PCB edge part (TDS-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
2026-10-23 Display bezel v2: refit the existing display case for the 3.2" CYD
    CAD/wqcs_display_v2.py rebuilds the bezel (Display_Cover.step) for the
    ESP32-2432S032C; the ring (WQCS_Display_Case_v1.step) is unchanged:
    - Its cavity (68.2 x 96.3) takes the 93.7 x 55 board. The board sits
    0.6 mm toward the bottom end to clear the old USB-notch tabs at the top.
    - Window: same 49.2 x 65.4 (both are 3.2" 320x240 panels), recentred on
    the CYD's off-centre active area (old opening filled, new one cut).
    - Four standoffs (dia 6, M3 pilot, CYD_STACK = 4 mm) on the 86.7 x 48
    pattern, so the glass sits against the bezel back, as the PyPortal did.
    Placement comes from the shared corner holes. Fit check: the bar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
2026-10-23 Display ring v2 + bezel: measured stack, no reset switch, boss trims
    - Measured CYD stack 4.8-5.0 mm (CYD_STACK 4.9: the standoffs grow) and
    back depth 7 mm with the speaker plugged in (5 mm without).
    - Ring v2 (WQCS_Display_Case_v2.step): the PyPortal reset-switch housing
    (8.5 x 8.5 x 4.5 block) is removed and its 6 x 6 wall hole filled flush
    (user: PyPortal only).
    - With the deeper stack the CYD's long edges caught the four corner
    screw bosses (bare-PCB overlap 0.9 mm^3). Their inner faces are trimmed
    behind the board's depth only, to 0.5 mm clearance. The screw holes are
    intact (19/19 dia-3 faces) and the flange is untouched.
    Fit: the bare PCB and glass clear the ring and beze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
2026-10-23 Speaker press-fit housing; CYD orientation and USB-C notch
    Enclosure: a press-fit housing for the 20 x 5 mm speaker on the display
    section's upper left wall, above the main PCB (y 40, z -3). Cup ID 20.2,
    6 flexible fingers with 0.7 mm inward lips (entry chamfered) holding the
    speaker's back edge, and 5 sound slits through the wall behind the cone.
    The base is sunk 0.3 mm into the wall so it fuses (the wall face is at
    x -75.45). Clear of the PCB parts, both TDS boards and the display.
    Display: the user's board, seen from the front, is the drawing rotated
    180 deg (RGB LED bottom-left, USB-C centred on the right edge). The active
    area is offset toward the LED end, so the window offset flips to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
2026-10-23 Speaker test coupon: 35 x 35 mm wall square with the press-fit housing
    Cut from the finished enclosure (same geometry as the real wall), so the
    speaker fit can be tested without printing the whole box: 35 x 35 x 8 mm,
    ~2.7 cm^3. STEP and STL. Print wall-down, cup up.
2026-10-23 Add a STEP model of the ESP32-2432S032C; use it in the display fit check
    No vendor 3D model exists, so CAD/cyd_model.py builds one from the
    manufacturer drawing plus the user's measurements: PCB 93.7 x 55 with
    4x dia 3.2 holes (86.7 x 48), glass/module 77.3 x 54.6 with a 4.9 mm
    stack, active area 64.8 x 48.6 offset toward the LED end, back envelope
    5 mm (7 mm speaker-plug zone, left), USB-C centred on the right edge (on
    the back; height to be confirmed), RGB LED bottom-left. Output:
    CAD/ESP32-2432S032C.step (named, coloured parts for Fusion).
    The display fit check now places this model in the bezel (gp_Trsf; a
    cq.Matrix wouldn't build this rotation). Results: the window centre
    matches the m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
2026-10-23 USB-C plug clearance: flange relief on the ring, rim notch on the enclosure
    Measured: the CYD's USB-C centre is 1.6 mm behind the PCB's back face. A
    standard plug (12.4 x 6.5 overmold) then reached 0.35 mm past the ring
    flange's outer face and 0.86 mm below the display section's right-wall
    rim, which it passes over.
    - Ring: the 14 mm USB notch and a 0.8 mm flange relief form one opening
    from the end wall's inner edge out to the flange edge.
    - Enclosure: a 14.4 x 1.6 mm notch in the right wall's rim, centred where
    the plug passes (y 24.2).
    The ring->enclosure transform comes from the flange holes sitting on the
    cover pads. A plug stand-in in both scripts now overlaps nothing.
    Co-Authored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
2026-10-23 Speaker housing: looser press fit after the first test print
    The first coupon was too tight: the speaker wouldn't pass the lip without
    breaking a finger. Bore 20.2 -> 20.4 (printed holes shrink), lip 0.7 ->
    0.45 mm, fingers 1.2 -> 1.0 mm thick, slits 4.5 -> 5.5 mm long. Each
    finger now flexes 0.25 mm (was 0.6) at about a third of the stiffness:
    roughly 1/8 of the insertion force, with a 0.25 mm lip still holding the
    speaker. Coupon and enclosure regenerated.
2026-10-24 Bezel: solid window fill, chamfered window, stack 4.3 mm
    From the test print:
    - The standoffs were too tall: a 0.5-0.7 mm gap at the glass. CYD_STACK
    4.9 (caliper) -> 4.3 (display script and CYD model), so the standoffs
    shorten 0.6 mm.
    - The strip filling the old window printed detached. The v1 window has a
    1 mm x 45 deg front chamfer, and the fill only covered the back opening,
    leaving a V-gap at the front. It now covers the whole chamfered opening,
    and the new window is cut like v1 (r1 corners, 1 mm front chamfer).
    Front-to-back slices show one tapered opening and no trace of the old one.
    The fit check is still clean, and the window is still centred on the
    active area. The USB-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
2026-10-24 Export STLs for all printable parts
    The display and enclosure scripts now write STL alongside STEP (binary,
    0.02 mm chord tolerance, 0.05 for the enclosure), so prints always match
    the current model: Display_Cover_v2.stl, WQCS_Display_Case_v2.stl,
    WQCS_Enclosure_v2.stl (plus the existing Speaker_Test_Coupon.stl).
2026-10-25 Display ring: remove the old PyPortal posts, ledges and USB-end tabs
    The CYD hangs from the bezel standoffs, so the four old PyPortal posts
    (on ledges off the corner bosses) and the leftover tabs inside the USB end
    wall only cost clearance and filament. They're cut inside the cavity,
    behind the bezel-lip seat and in front of the flange face. The corner
    screw bosses (dia 8, dia 5 holes) are protected by a dia 8.4 keep-out:
    all four intact. Ring 10.87 -> 10.42 cm^3. The module gap is 0.89 ->
    3.8 mm; the USB-end and side-post pinch points are gone. The tightest
    spot left is 0.5 mm, where the round corner bosses meet the board's
    corners. The bezel fit (0.47 lip) and the USB plug path are unchang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
2026-10-25 Display ring: remove the old posts through the full depth
    The previous cut only spanned mid-depth (y 24..33.26), so the posts'
    front stubs and the 2 mm back ledge layer stayed (seen on the print). The
    corner cuts now span the full ring depth, the boss keep-out is limited to
    the original boss length (y 22.27..31.77), and the USB-end strip is
    trimmed back to the lip seat, like the opposite end. Left in the cavity:
    the four corner screw bosses and the bezel-lip seats only. Ring 10.42 ->
    9.98 cm^3. The bezel fit, USB path and CYD clearance are unchanged.
2026-10-25 Display ring: remove the corner bosses (the bezel snaps on via ridges)
    User: the bezel snaps on with the four long triangular ridges on the ring's
    inner front edge, so the four corner bosses hold nothing. They're cut
    inside the cavity only, so the corner walls and outer size (79.5 x 109.5)
    are unchanged. Inside the ring now: just the four snap ridges, intact,
    and the bezel-ring overlap is still the ridge engagement (0.46 mm^3).
    Ring 9.98 -> 9.71 cm^3. The CYD PCB's tightest gap is 0.5 -> 0.66 mm.
2026-10-25 Display ring: fill the PyPortal D-hole / SD-card opening in the end wall
    The original ring had one 31 mm opening through the USB end wall
    (x 25.34..56.65) behind a thicker inner layer with the D-shaped and
    SD-card cut-outs. With that layer gone, the whole old opening was open.
    It's now filled to a plain 1.5 mm wall (user request) before the 14 mm
    USB-C notch and flange relief are cut. The only opening in that wall is
    now the USB-C notch. The snap ridges, bezel fit, USB plug path and CYD
    clearance are unchanged.
2026-10-25 Enclosure v2: 4 mm outer walls, longer bottom, 3 mm switch housing, 3 mm bezel
    - Tube bulkhead holes kept at their v1 positions through the +4 mm lift
    - Outer side/end walls grown 2 mm outward (2 -> 4 mm); every wall opening
    carried through, so no hole moves; lid v2 gets a matching border
    - Bottom end (solenoid end wall) dropped 5 mm by stretching the mechanical
    section and lid at y -170
    - Pressure-switch housing rebuilt with 3 mm walls (pocket unchanged) and
    dropped 5 mm
    - Display bezel front plate 1.5 -> 3 mm, grown forward; window chamfer
    grows with it so the viewing angle is unchanged
2026-10-25 Add mechanical-section fit test with tubing, fittings and switch wiring
    wqcs_fit_test.py places the user's solenoid, pressure switch and motorized
    valve models in enclosure v2, routes the 1/4" tubing and push-fit fittings
    along the water path traced from IMG_6381 (IN left bulkhead -> switch ->
    ball valve -> solenoid -> OUT right bulkhead), adds the switch's two pins
    and their wires through the cable slot, and reports clashes (none).
    Fitting, pin and wire sizes are estimates. MotorizeValve.step is an empty
    export; the valve comes from Pressure_switch.step.
2026-10-28 Enclosure v2: inlet on the pressure-switch axis, 12 mm TDS probe hole; lid in fit test
    - IN (left) bulkhead hole moved onto the pressure switch's tube axis
    (y -121.7, z 13.4, derived from PSW_TUBE_AXIS - PSW_DROP), so the inlet
    tube runs straight into the switch; the old hole is filled
    - TDS probe cable hole in the mechanical section's right wall (above the
    water outlet) opened from dia 8 to dia 12; the display section's dia-8
    power-jack hole is unchanged
    - Fit test now includes lid v2 on the rim and checks parts against it
2026-10-28 Enclosure v2: move power jack up to 25 mm below the display top, clear of the PCB
